MatthewNutt5/MicroTracker/README.md

# MicroTracker
Handheld, battery-powered music sequencer and synthesizer.
