MatthewNutt5/MicroTracker/kicad/source/mt.kicad_pcb

## KiCad design kicad/source/mt.kicad_pcb (2025-04-17)

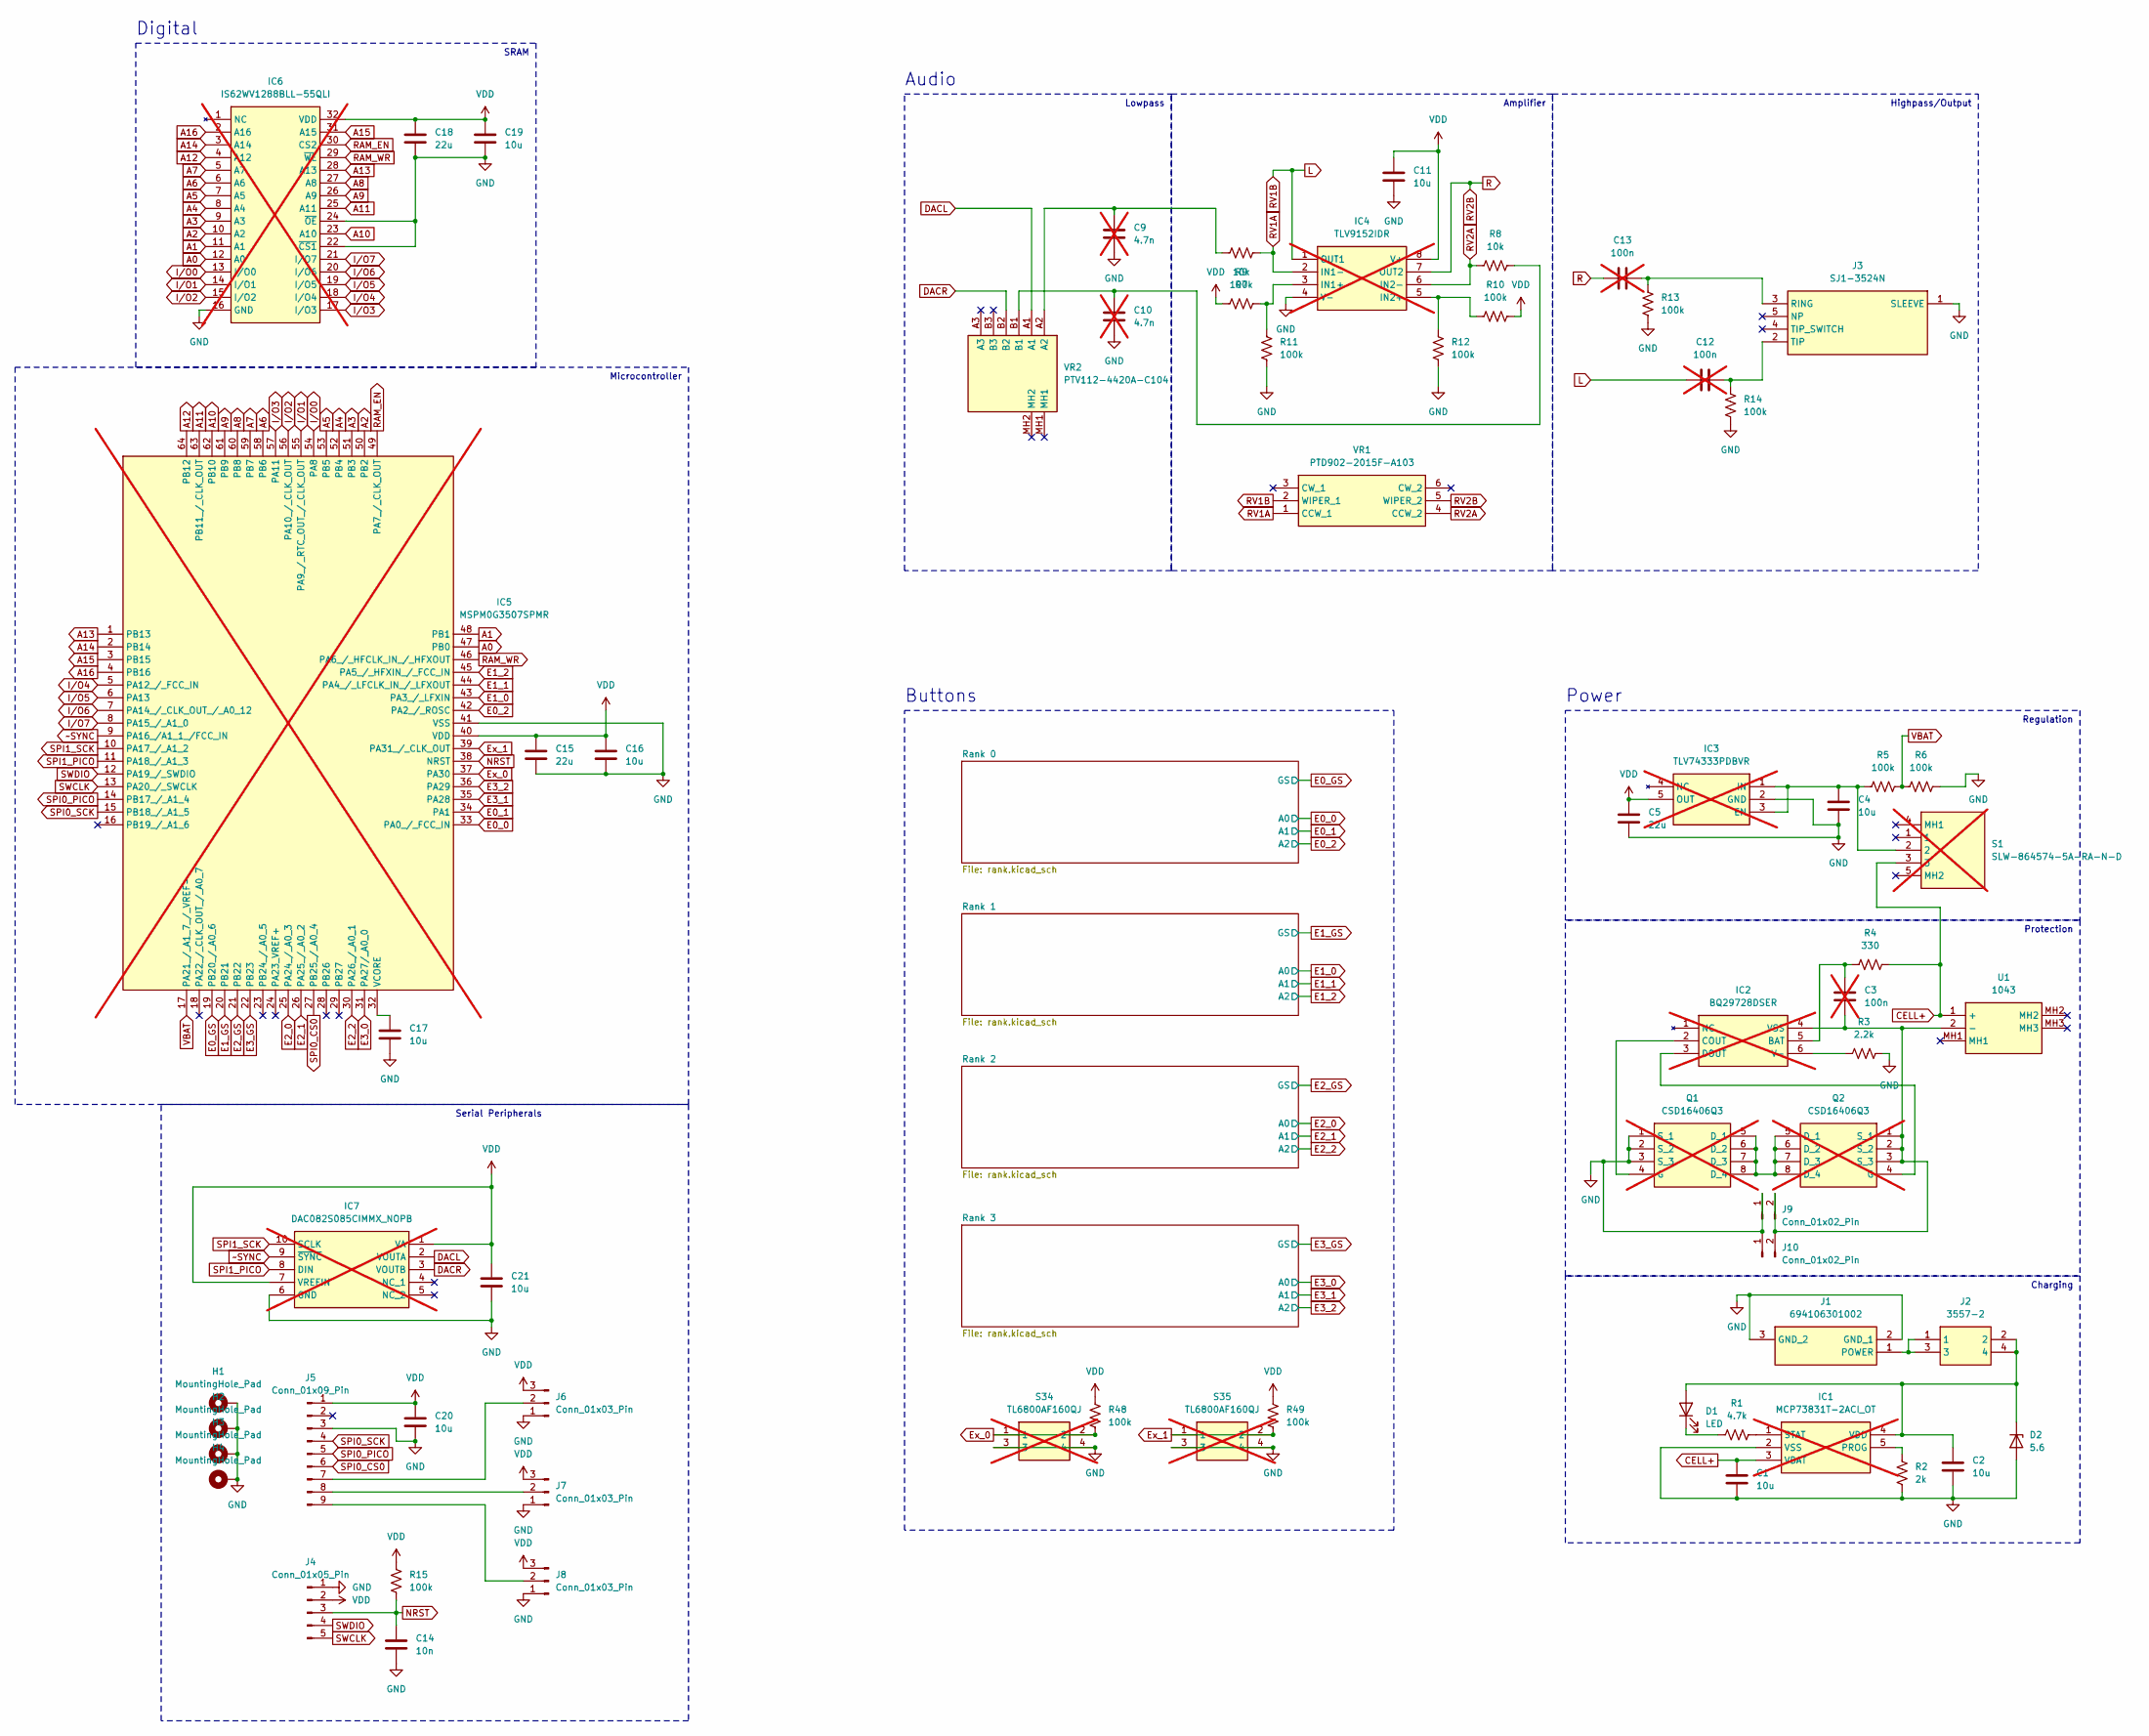
[picture p1: schematic mt.kicad_sch]

Parts:
C1, C2, C4, C11, C16, C17, C19, C20, C21: 10u; C_0402_1005Metric; JLCPCB C15525
C3, C12, C13: 100n; C_1206_3216Metric_Pad1.33x1.80mm_HandSolder; JLCPCB C97946; not fitted
C5, C15, C18: 22u; C_0603_1608Metric; JLCPCB C59461
C9, C10: 4.7n; C_0603_1608Metric_Pad1.08x0.95mm_HandSolder; JLCPCB C1518204; not fitted
C14: 10n; C_0402_1005Metric; JLCPCB C15195
D1: LED; LED_D5.0mm
D2: 5.6; D_SOD-123; JLCPCB C173406
H1, H2, H3, H4: MountingHole_Pad; MountingHole_3.2mm_M3_Pad_Via
IC1: MCP73831T-2ACI_OT; SOT95P270X145-5N; Mouser Part Number 579-MCP73831T-2ACIOT; not fitted
IC2: BQ29728DSER; Mouser Part Number 595-BQ29728DSER; not fitted
IC3: TLV74333PDBVR; SOT95P280X145-5N; Mouser Part Number 595-TLV74333PDBVR; not fitted
IC4: TLV9152IDR; SOIC127P600X175-8N; Mouser Part Number 595-TLV9152IDR; not fitted
IC5: MSPM0G3507SPMR; QFP50P1200X1200X160-64N; Mouser Part Number 595-MSPM0G3507SPMR; not fitted
IC6: IS62WV1288BLL-55QLI; SOIC127P1412X300-32N; Mouser Part Number 87062WV1288BLL55QLI; not fitted
IC7: DAC082S085CIMMX_NOPB; SOP50P490X110-10N; Mouser Part Number 926-D082S085CIMMXNPB; not fitted
J1: 694106301002; 694106301002_1; Mouser Part Number 710-694106301002
J2: 3557-2; Mouser Part Number 534-3557-2
J3: SJ1-3524N; SJ13524N; Mouser Part Number 490-SJ1-3524N
J4: Conn_01x05_Pin; PinHeader_1x05_P2.54mm_Horizontal
J5: Conn_01x09_Pin; PinSocket_1x09_P2.54mm_Vertical
J6, J7, J8: Conn_01x03_Pin; PinHeader_1x03_P2.54mm_Vertical
J9, J10: Conn_01x02_Pin; PinHeader_1x02_P2.54mm_Vertical
Q1, Q2: CSD16406Q3; DQG_VSON-CLIP; Mouser Part Number 595-CSD16406Q3; not fitted
R1: 4.7k; R_0402_1005Metric; JLCPCB C25900
R2: 2k; R_0402_1005Metric; JLCPCB C4109
R3: 2.2k; R_0402_1005Metric; JLCPCB C25879
R4: 330; R_0402_1005Metric; JLCPCB C25104
R5, R6, R9, R10, R11, R12, R13, R14, R15, R48, R49: 100k; R_0402_1005Metric; JLCPCB C25741
R7, R8: 10k; R_0402_1005Metric; JLCPCB C25744
S1: SLW-864574-5A-RA-N-D; SLW8645745ARAND; Mouser Part Number 179-SLW8645745ARAND; not fitted
S34, S35: TL6800AF160QJ; Mouser Part Number 612-TL6800AF160QG; not fitted
U1: 1043; Mouser Part Number 534-1043
VR1: PTD902-2015F-A103; PTD9022015FA103; Mouser Part Number 652-PTD902-2015FA103
VR2: PTV112-4420A-C104; PTV1124420AC104; Mouser Part Number 652-PTV1124420AC104

Connections:
A0: IC5.47 (PB0), IC6.12 (A0)
A1: IC5.48 (PB1), IC6.11 (A1)
A2: IC5.50 (PB2), IC6.10 (A2)
A3: IC5.51 (PB3), IC6.9 (A3)
A4: IC5.52 (PB4), IC6.8 (A4)
A5: IC5.53 (PB5), IC6.7 (A5)
A6: IC5.58 (PB6), IC6.6 (A6)
A7: IC5.59 (PB7), IC6.5 (A7)
A8: IC5.60 (PB8), IC6.27 (A8)
A9: IC5.61 (PB9), IC6.26 (A9)
A10: IC5.62 (PB10), IC6.23 (A10)
A11: IC5.63 (PB11_/_CLK_OUT), IC6.25 (A11)
A12: IC5.64 (PB12), IC6.4 (A12)
A13: IC5.1 (PB13), IC6.28 (A13)
A14: IC5.2 (PB14), IC6.3 (A14)
A15: IC5.3 (PB15), IC6.31 (A15)
A16: IC5.4 (PB16), IC6.2 (A16)
CELL+: C1.1, IC1.3 (VBAT), R4.1, S1.3, U1.1 (+)
DACL: IC7.2 (VOUTA), VR2.A1
DACR: IC7.3 (VOUTB), VR2.B2
E0_0: IC5.33 (PA0_/_FCC_IN); also elsewhere on the board
E0_1: IC5.34 (PA1); also elsewhere on the board
E0_2: IC5.42 (PA2_/_ROSC); also elsewhere on the board
E0_GS: IC5.19 (PB20_/_A0_6); also elsewhere on the board
E1_0: IC5.43 (PA3_/_LFXIN); also elsewhere on the board
E1_1: IC5.44 (PA4_/_LFCLK_IN_/_LFXOUT); also elsewhere on the board
E1_2: IC5.45 (PA5_/_HFXIN_/_FCC_IN); also elsewhere on the board
E1_GS: IC5.20 (PB21); also elsewhere on the board
E2_0: IC5.25 (PA24_/_A0_3); also elsewhere on the board
E2_1: IC5.26 (PA25_/_A0_2); also elsewhere on the board
E2_2: IC5.30 (PA26_/_A0_1); also elsewhere on the board
E2_GS: IC5.21 (PB22); also elsewhere on the board
E3_0: IC5.31 (PA27/_A0_0); also elsewhere on the board
E3_1: IC5.35 (PA28); also elsewhere on the board
E3_2: IC5.36 (PA29); also elsewhere on the board
E3_GS: IC5.22 (PB23); also elsewhere on the board
Ex_0: IC5.37 (PA30), R48.2, S34.1, S34.2
Ex_1: IC5.39 (PA31_/_CLK_OUT), R49.2, S35.1, S35.2
GND: C1.2, C2.2, C4.2, C5.2, C9.2, C10.2, C11.2, C14.2, C15.2, C16.2, C17.2, C18.2, C19.2, C20.2, C21.2, D2.2 (A), H1.1, H2.1, H3.1, H4.1, IC1.2 (VSS), IC3.2 (GND), IC4.4 (V-), IC5.41 (VSS), IC6.16 (GND), IC6.22 (~CS1), IC6.24 (~OE), IC7.6 (GND), J1.2 (GND_1), J1.3 (GND_2), J3.1 (SLEEVE), J4.1, J5.3, J6.1, J7.1, J8.1, J9.1, J10.1, Q1.1 (S_1), Q1.2 (S_2), Q1.3 (S_3), R2.2, R3.1, R6.2, R11.2, R12.1, R13.2, R14.2, S34.3, S34.4, S35.3, S35.4; also elsewhere on the board
I/O0: IC5.54 (PA8), IC6.13 (I/O0)
I/O1: IC5.55 (PA9_/_RTC_OUT_/_CLK_OUT), IC6.14 (I/O1)
I/O2: IC5.56 (PA10_/_CLK_OUT), IC6.15 (I/O2)
I/O3: IC5.57 (PA11), IC6.17 (I/O3)
I/O4: IC5.5 (PA12_/_FCC_IN), IC6.18 (I/O4)
I/O5: IC5.6 (PA13), IC6.19 (I/O5)
I/O6: IC5.7 (PA14_/_CLK_OUT_/_A0_12), IC6.20 (I/O6)
I/O7: IC5.8 (PA15_/_A1_0), IC6.21 (I/O7)
L: C12.1, IC4.1 (OUT1), VR1.2 (WIPER_1)
NRST: C14.1, IC5.38 (NRST), J4.3, R15.2
unnamed: C9.1, R7.1, VR2.A2
unnamed: C10.1, R8.1, VR2.B1
unnamed: C2.1, D1.2 (A), D2.1 (K), IC1.4 (VDD), J2.2, J2.4
unnamed: D1.1 (K), R1.1
unnamed: IC1.5 (PROG), R2.1
unnamed: IC1.1 (STAT), R1.2
unnamed: C3.1, IC2.5 (BAT), R4.2
unnamed: IC2.2 (COUT), Q1.4 (G)
unnamed: IC2.3 (DOUT), Q2.4 (G)
unnamed: IC2.6 (V-), R3.2
unnamed: C3.2, IC2.4 (VSS), J9.2, J10.2, Q2.1 (S_1), Q2.2 (S_2), Q2.3 (S_3), U1.2 (-)
unnamed: C4.1, IC3.1 (IN), IC3.3 (EN), R5.2, S1.2
unnamed: IC4.3 (IN1+), R9.2, R11.1
unnamed: IC4.5 (IN2+), R10.1, R12.2
unnamed: C17.1, IC5.32 (VCORE)
unnamed: J1.1 (POWER), J2.1, J2.3
unnamed: C13.2, J3.3 (RING), R13.1
unnamed: C12.2, J3.2 (TIP), R14.1
unnamed: J5.7, J6.2
unnamed: J5.8, J7.2
unnamed: J5.9, J8.2
unnamed: Q1.5 (D_1), Q1.6 (D_2), Q1.7 (D_3), Q1.8 (D_4), Q2.5 (D_1), Q2.6 (D_2), Q2.7 (D_3), Q2.8 (D_4)
R: C13.1, IC4.7 (OUT2), VR1.5 (WIPER_2)
RAM_EN: IC5.49 (PA7_/_CLK_OUT), IC6.30 (CS2)
RAM_WR: IC5.46 (PA6_/_HFCLK_IN_/_HFXOUT), IC6.29 (~WE)
RV1A: IC4.2 (IN1-), R7.2, VR1.1 (CCW_1)
RV2A: IC4.6 (IN2-), R8.2, VR1.4 (CCW_2)
SPI0_CS0: IC5.27 (PB25_/_A0_4), J5.6
SPI0_PICO: IC5.14 (PB17_/_A1_4), J5.5
SPI0_SCK: IC5.15 (PB18_/_A1_5), J5.4
SPI1_PICO: IC5.11 (PA18_/_A1_3), IC7.8 (DIN)
SPI1_SCK: IC5.10 (PA17_/_A1_2), IC7.10 (SCLK)
SWCLK: IC5.13 (PA20_/_SWCLK), J4.5
SWDIO: IC5.12 (PA19_/_SWDIO), J4.4
VBAT: IC5.17 (PA21_/_A1_7_/_VREF-), R5.1, R6.1
VDD: C5.1, C11.1, C15.1, C16.1, C18.1, C19.1, C20.1, C21.1, IC3.5 (OUT), IC4.8 (V+), IC5.40 (VDD), IC6.32 (VDD), IC7.1 (VA), IC7.7 (VREFIN), J4.2, J5.1, J6.3, J7.3, J8.3, R9.1, R10.2, R15.1, R48.1, R49.1; also elsewhere on the board
~SYNC: IC5.9 (PA16_/A1_1_/FCC_IN), IC7.9 (~SYNC)

Notes on the sheet:
Audio
Charging
Highpass/Output
SRAM
Protection
Buttons
Amplifier
Microcontroller
Power
Serial Peripherals
Regulation
Lowpass
Digital

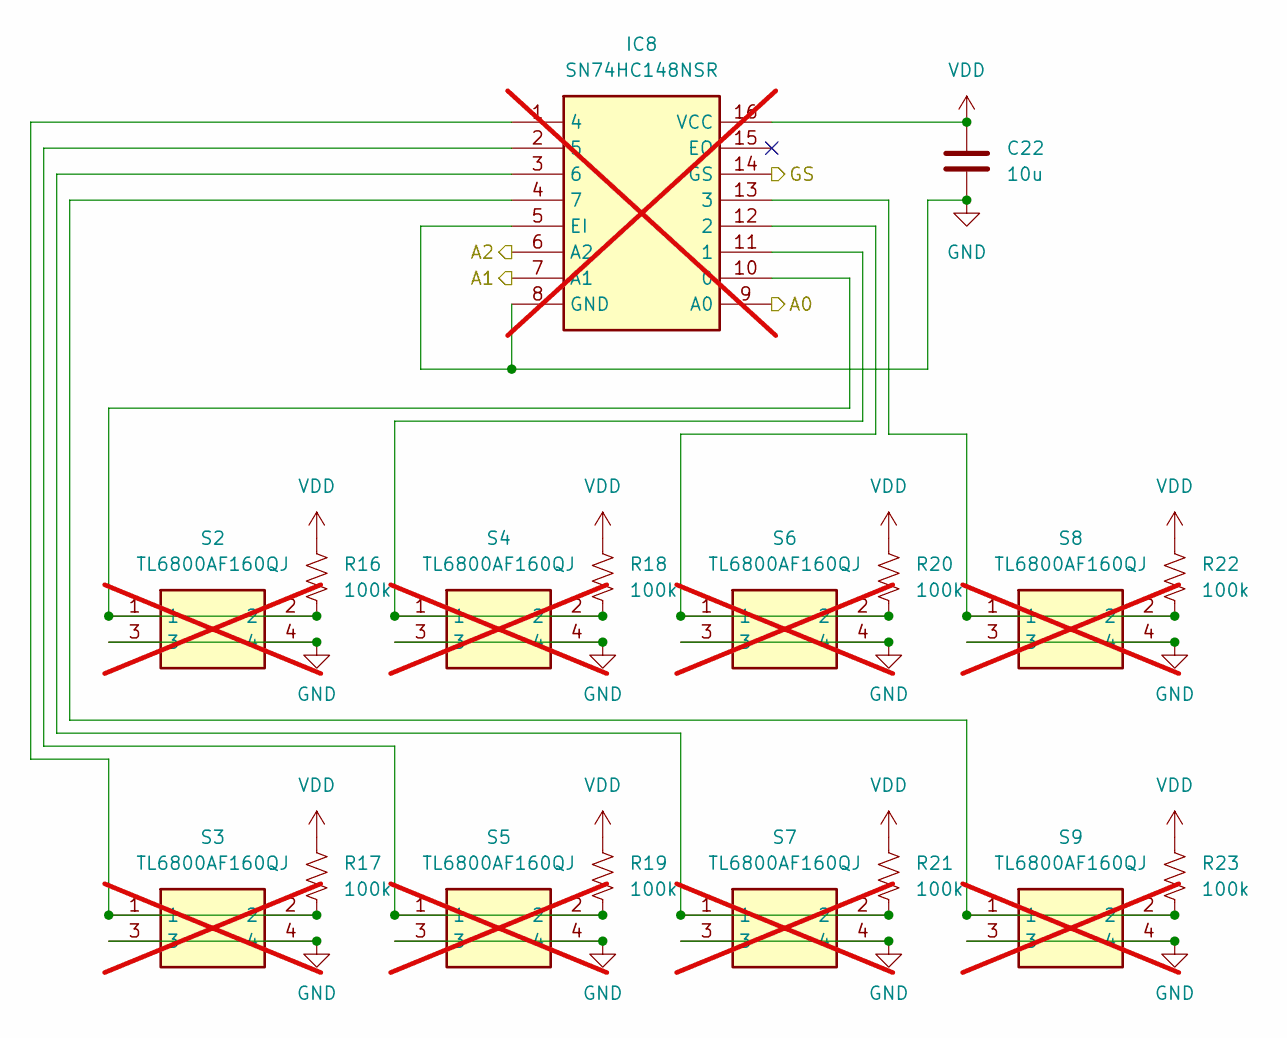
[picture p2: schematic rank.kicad_sch]

Parts:
C22: 10u; C_0402_1005Metric; JLCPCB C15525
IC8: SN74HC148NSR; SOIC127P780X200-16N; Mouser Part Number 595-SN74HC148NSR; not fitted
R16, R17, R18, R19, R20, R21, R22, R23: 100k; R_0402_1005Metric; JLCPCB C25741
S2, S3, S4, S5, S6, S7, S8, S9: TL6800AF160QJ; Mouser Part Number 612-TL6800AF160QG; not fitted

Connections:
E0_0: IC8.9 (A0); also elsewhere on the board
E0_1: IC8.7 (A1); also elsewhere on the board
E0_2: IC8.6 (A2); also elsewhere on the board
E0_GS: IC8.14 (GS); also elsewhere on the board
GND: C22.2, IC8.5 (EI), IC8.8 (GND), S2.3, S2.4, S3.3, S3.4, S4.3, S4.4, S5.3, S5.4, S6.3, S6.4, S7.3, S7.4, S8.3, S8.4, S9.3, S9.4; also elsewhere on the board
unnamed: IC8.10 (0), R16.2, S2.1, S2.2
unnamed: IC8.11 (1), R18.2, S4.1, S4.2
unnamed: IC8.12 (2), R20.2, S6.1, S6.2
unnamed: IC8.13 (3), R22.2, S8.1, S8.2
unnamed: IC8.1 (4), R17.2, S3.1, S3.2
unnamed: IC8.2 (5), R19.2, S5.1, S5.2
unnamed: IC8.3 (6), R21.2, S7.1, S7.2
unnamed: IC8.4 (7), R23.2, S9.1, S9.2
VDD: C22.1, IC8.16 (VCC), R16.1, R17.1, R18.1, R19.1, R20.1, R21.1, R22.1, R23.1; also elsewhere on the board

Parts of its further copies:
C23, C24, C25: 10u; C_0402_1005Metric; JLCPCB C15525
IC9, IC10, IC11: SN74HC148NSR; SOIC127P780X200-16N; Mouser Part Number 595-SN74HC148NSR; not fitted
R24, R25, R26, R27, R28, R29, R30, R31, R32, R33, R34, R35, R36, R37, R38, R39, R40, R41, R42, R43, R44, R45, R46, R47: 100k; R_0402_1005Metric; JLCPCB C25741
S10, S11, S12, S13, S14, S15, S16, S17, S18, S19, S20, S21, S22, S23, S24, S25, S26, S27, S28, S29, S30, S31, S32, S33: TL6800AF160QJ; Mouser Part Number 612-TL6800AF160QG; not fitted

Connections of its further copies:
E1_0: IC9.9 (A0); also elsewhere on the board
E1_1: IC9.7 (A1); also elsewhere on the board
E1_2: IC9.6 (A2); also elsewhere on the board
E1_GS: IC9.14 (GS); also elsewhere on the board
E2_0: IC10.9 (A0); also elsewhere on the board
E2_1: IC10.7 (A1); also elsewhere on the board
E2_2: IC10.6 (A2); also elsewhere on the board
E2_GS: IC10.14 (GS); also elsewhere on the board
E3_0: IC11.9 (A0); also elsewhere on the board
E3_1: IC11.7 (A1); also elsewhere on the board
E3_2: IC11.6 (A2); also elsewhere on the board
E3_GS: IC11.14 (GS); also elsewhere on the board
GND: C23.2, C24.2, C25.2, IC9.5 (EI), IC9.8 (GND), IC10.5 (EI), IC10.8 (GND), IC11.5 (EI), IC11.8 (GND), S10.3, S10.4, S11.3, S11.4, S12.3, S12.4, S13.3, S13.4, S14.3, S14.4, S15.3, S15.4, S16.3, S16.4, S17.3, S17.4, S18.3, S18.4, S19.3, S19.4, S20.3, S20.4, S21.3, S21.4, S22.3, S22.4, S23.3, S23.4, S24.3, S24.4, S25.3, S25.4, S26.3, S26.4, S27.3, S27.4, S28.3, S28.4, S29.3, S29.4, S30.3, S30.4, S31.3, S31.4, S32.3, S32.4, S33.3, S33.4; also elsewhere on the board
unnamed: IC9.10 (0), R24.2, S10.1, S10.2
unnamed: IC9.11 (1), R26.2, S12.1, S12.2
unnamed: IC9.12 (2), R28.2, S14.1, S14.2
unnamed: IC9.13 (3), R30.2, S16.1, S16.2
unnamed: IC9.1 (4), R25.2, S11.1, S11.2
unnamed: IC9.2 (5), R27.2, S13.1, S13.2
unnamed: IC9.3 (6), R29.2, S15.1, S15.2
unnamed: IC9.4 (7), R31.2, S17.1, S17.2
unnamed: IC10.10 (0), R32.2, S18.1, S18.2
unnamed: IC10.11 (1), R34.2, S20.1, S20.2
unnamed: IC10.12 (2), R36.2, S22.1, S22.2
unnamed: IC10.13 (3), R38.2, S24.1, S24.2
unnamed: IC10.1 (4), R33.2, S19.1, S19.2
unnamed: IC10.2 (5), R35.2, S21.1, S21.2
unnamed: IC10.3 (6), R37.2, S23.1, S23.2
unnamed: IC10.4 (7), R39.2, S25.1, S25.2
unnamed: IC11.10 (0), R40.2, S26.1, S26.2
unnamed: IC11.11 (1), R42.2, S28.1, S28.2
unnamed: IC11.12 (2), R44.2, S30.1, S30.2
unnamed: IC11.13 (3), R46.2, S32.1, S32.2
unnamed: IC11.1 (4), R41.2, S27.1, S27.2
unnamed: IC11.2 (5), R43.2, S29.1, S29.2
unnamed: IC11.3 (6), R45.2, S31.1, S31.2
unnamed: IC11.4 (7), R47.2, S33.1, S33.2
VDD: C23.1, C24.1, C25.1, IC9.16 (VCC), IC10.16 (VCC), IC11.16 (VCC), R24.1, R25.1, R26.1, R27.1, R28.1, R29.1, R30.1, R31.1, R32.1, R33.1, R34.1, R35.1, R36.1, R37.1, R38.1, R39.1, R40.1, R41.1, R42.1, R43.1, R44.1, R45.1, R46.1, R47.1; also elsewhere on the board

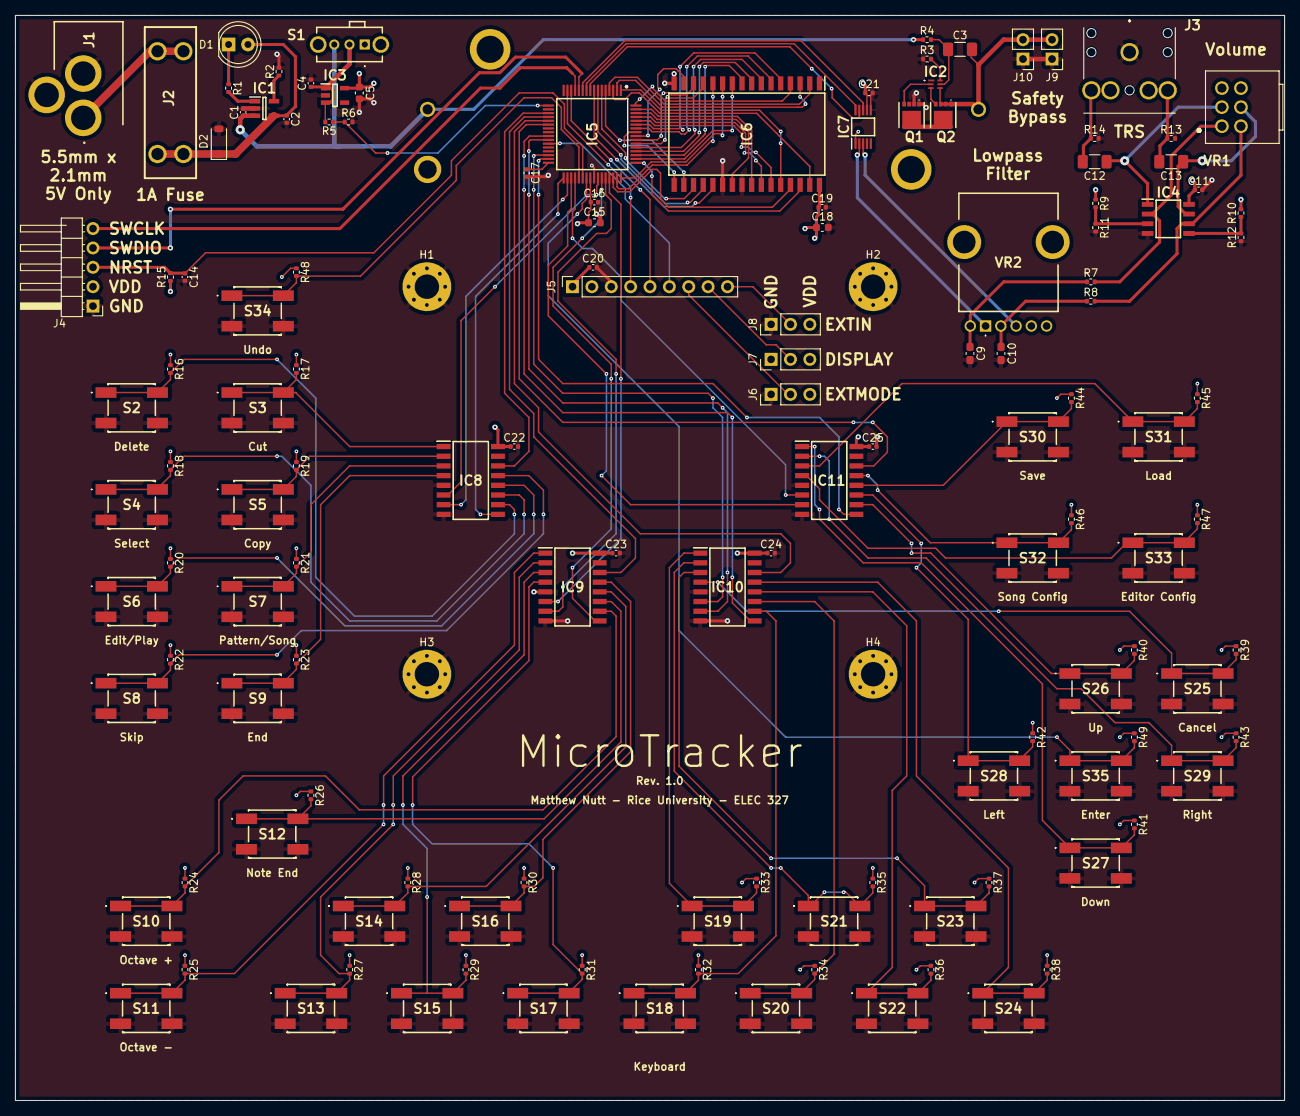
[picture p3: board mt.kicad_pcb from above]

Board: 4 copper layers, 166.4 x 142.2 mm, 138 parts (1 on the bottom side), 118 nets.
