MatthewNutt5/MicroTracker/(commit log)

2025-04-03 added kicad files, gitignore
    [mt.kicad_pcb, mt.kicad_sch]
2025-04-04 completed power electronics schematic
    [mt.kicad_pcb, mt.kicad_sch]
2025-04-04 revised power electronics caps, added JLCPCB part numbers to SMD power electronics
    [mt.kicad_sch]
2025-04-04 completed audio electronics schematic
    [mt.kicad_sch]
2025-04-04 revised audio electronics volume pot
    [mt.kicad_pcb, mt.kicad_sch]
2025-04-07 revised some passives, started digital electronics schematic
    [mt.kicad_sch]
2025-04-08 started sram schematic
    [mt.kicad_sch]
2025-04-08 simplified power electronics
    [mt.kicad_pcb, mt.kicad_sch]
2025-04-08 completed full schematic
    [mt.kicad_pcb, mt.kicad_sch]
2025-04-09 configured PCB with 4-layer stackup and JLCPCB DRC rules
    [mt.kicad_pcb]
2025-04-09 added input OVP, screen config jumpers
    [mt.kicad_pcb, mt.kicad_sch]
2025-04-09 configured PCB trace/via sizes
2025-04-14 started routing SRAM on PCB
    [mt.kicad_pcb]
2025-04-15 completed SRAM routing, started power electronics routing
    [mt.kicad_pcb]
2025-04-15 completed power electronics routing, fixed battery holder model
    [mt.kicad_pcb, mt.kicad_sch]
2025-04-15 completed analog electronics routing
    [mt.kicad_pcb, mt.kicad_sch]
2025-04-16 completed peripherals routing, set up zone fills
    [mt.kicad_pcb, mt.kicad_sch]
2025-04-16 converted button ranks to hierarchical schematics, prepared button layout pattern
    [mt.kicad_pcb, mt.kicad_sch, rank.kicad_sch]
2025-04-16 completed buttons arrangement
    [mt.kicad_pcb]
2025-04-16 completed button-encoder routing
    [mt.kicad_pcb]
2025-04-16 started encoder-microcontroller routing
    [mt.kicad_pcb]
2025-04-16 completed all routing
    [mt.kicad_pcb]
2025-04-16 misc adjustments
    [mt.kicad_pcb]
2025-04-17 completed PCB fab setup
    [mt-B_Cu.gbr, mt-B_Mask.gbr, mt-B_Paste.gbr, mt-B_Silkscreen.gbr, mt-Edge_Cuts.gbr, mt-F_Cu.gbr, mt-F_Mask.gbr, mt-F_Paste.gbr]
2025-04-17 adjusted PCB fab setup for faster manufacturing
    [mt-B_Cu.gbr, mt-B_Mask.gbr, mt-B_Paste.gbr, mt-B_Silkscreen.gbr, mt-Edge_Cuts.gbr, mt-F_Cu.gbr, mt-F_Mask.gbr, mt-F_Paste.gbr]
2025-04-17 reorganized files
    [mt-B_Cu.gbr, mt-B_Mask.gbr, mt-B_Paste.gbr, mt-B_Silkscreen.gbr, mt-Edge_Cuts.gbr, mt-F_Cu.gbr, mt-F_Mask.gbr, mt-F_Paste.gbr]
